mohilp1998/BTP/README.md

# BTP

Documents: Will contain basic Documents of the Project.
Project_Till_BTP-I: Contains the codes till BTP-I completion i.e. till DEC-2019.

For all the details refer to BTP_II_Report.pdf in Documents folder.
