mohilp1998/BTP/BTP-II/CCS_code/BTP_2_Flow/Flash.c

/*
 * Flash.c
 *
 *  Created on: Apr 16, 2020
 *      Author: Mohil
 */

#include "main.h"

/*
 * Following are defined here externally as including tm4c123gh6pm.h leads to conflicting redefinition with hw_insts.h
 * for INT_TIMER1A, which will cause issues with timer interrupt
 */
#define FLASH_BOOTCFG_R         (*((volatile uint32_t *)0x400FE1D0))
#define FLASH_FMA_R             (*((volatile uint32_t *)0x400FD000))
#define FLASH_FMD_R             (*((volatile uint32_t *)0x400FD004))
#define FLASH_FMC_R             (*((volatile uint32_t *)0x400FD008))

// This holds the key required for erase, write and password_init operations. Set it during Enable().
uint16_t flashKey_ = 0;

//*****************************************************************************
void Flash_Enable(void)
{
    if (FLASH_BOOTCFG_R & 0x10) {
            flashKey_ = 0xA442;
        }
        else {
            flashKey_ = 0x71D5;
        }
}

//*****************************************************************************
int Flash_Erase(int blockCount)
{

    int i;
    // Make sure Enable was called.
    if (flashKey_ == 0) {
        return -1;
    }

    for (i = 0; i < blockCount; i++) {

        // Clear then set the OFFSET (17:0) with the write address.
        FLASH_FMA_R &= 0xFFFC0000;

        // Blocks are erased on 1KiB boundaries, so multiply the index by 1024
        //  and add this to the base address.
        FLASH_FMA_R |= ((uint32_t)FLASH_BASE_ADDR) + (i*1024);

        // Set the ERASE command bit.
        FLASH_FMC_R = (flashKey_ << 16) | 0x2;

        // Poll the ERASE bit until it is cleared.
        while (FLASH_FMC_R & 0x2) {}

    }

    return 0;
}

//*****************************************************************************
int Flash_Write(const void* data, int wordCount)
{

    // Make sure Enable was called.
    if (flashKey_ == 0) {
        return -1;
    }

    // Must erase the data first.  A write may only change a bit from 1 to 0, so if the
    //  bit is already zero, the write fails.  Erasing will set all bits to 1's.
    //  Calculate the number of 1KiB blocks that the data will span and erase that many.
    int blockCount = ((wordCount * sizeof(uint32_t)) / 1024) + 1;
    Flash_Erase(blockCount);

    // Write one word at a time...
    int i;
    for (i = 0; i < wordCount; i++) {

        // Set the data register.  This the word that will be written.
        FLASH_FMD_R = ((volatile uint32_t*)data)[i];

        // Clear then set the OFFSET address field (17:0) with the write address.
        FLASH_FMA_R &= 0xFFFC0000;
        FLASH_FMA_R |= (uint32_t)FLASH_BASE_ADDR + (i * sizeof(uint32_t));

        // Trigger a write operation...
        FLASH_FMC_R = (flashKey_ << 16) | 0x1;

        // Poll the WRITE bit until it is cleared.
        while (FLASH_FMC_R & 0x1) {}

    }

    return 0;

}

//*****************************************************************************
void Flash_Read(void* data, int wordCount)
{
    // Copy the count of bytes into the target data buffer...
    int i;
    for (i = 0; i < wordCount; i++) {
        ((uint32_t*)data)[i] = FLASH_BASE_ADDR[i];
    }

}

//*****************************************************************************
int NoLongerFirstTime(void)
{
    uint32_t i = 0;
    // Make sure Enable was called.
    if (flashKey_ == 0) {
        return -1;
    }

    // Clear then set the OFFSET (17:0) with the write address.
    FLASH_FMA_R &= 0xFFFC0000;

    // Blocks are erased on 1KiB boundaries, so multiply the index by 1024
    //  and add this to the base address.
    FLASH_FMA_R |= ((uint32_t)FLASH_BASE_INIT_ADDR);

    // Set the ERASE command bit.
    FLASH_FMC_R = (flashKey_ << 16) | 0x2;

    // Poll the ERASE bit until it is cleared.
    while (FLASH_FMC_R & 0x2) {}


    // Set the data register.  This the word that will be written.
    FLASH_FMD_R = i;

    // Clear then set the OFFSET address field (17:0) with the write address.
    FLASH_FMA_R &= 0xFFFC0000;
    FLASH_FMA_R |= (uint32_t)FLASH_BASE_INIT_ADDR;

    // Trigger a write operation...
    FLASH_FMC_R = (flashKey_ << 16) | 0x1;

    // Poll the WRITE bit until it is cleared.
    while (FLASH_FMC_R & 0x1) {}


    return 0;
}
